EduBalbinot/ThreePhaseInverter/Resultados/T0000CH1.CSV

Model | DPO2024
Firmware Version | 1.25
Point Format | Y
Horizontal Units | S
Horizontal Scale | 1e-05
Sample Interval | 1e-09
Filter Frequency | 2e+08
Record Length | 100000
Gating | 0.0% to 100.0%
Probe Attenuation | 10
Vertical Units | V
Vertical Offset | 0
Vertical Scale | 50
Label
TIME | CH1
-4.87200e-05 | -3
-4.87190e-05 | -5
-4.87180e-05 | -3
-4.87170e-05 | -3
-4.87160e-05 | -5
-4.87150e-05 | -5
-4.87140e-05 | -5
-4.87130e-05 | -5
-4.87120e-05 | -5
-4.87110e-05 | -5
-4.87100e-05 | -5
-4.87090e-05 | -5
-4.87080e-05 | -3
-4.87070e-05 | -3
-4.87060e-05 | -5
-4.87050e-05 | -3
-4.87040e-05 | -5
-4.87030e-05 | -3
-4.87020e-05 | -5
-4.87010e-05 | -5
-4.87000e-05 | -5
-4.86990e-05 | -3
-4.86980e-05 | -3
-4.86970e-05 | -5
-4.86960e-05 | -5
-4.86950e-05 | -5
-4.86940e-05 | -5
-4.86930e-05 | -5
-4.86920e-05 | -5
-4.86910e-05 | -5
-4.86900e-05 | -5
-4.86890e-05 | -3
-4.86880e-05 | -5
-4.86870e-05 | -5
-4.86860e-05 | -3
-4.86850e-05 | -5
-4.86840e-05 | -5
-4.86830e-05 | -5
-4.86820e-05 | -5
-4.86810e-05 | -5
-4.86800e-05 | -5
-4.86790e-05 | -5
-4.86780e-05 | -5
-4.86770e-05 | -5
-4.86760e-05 | -5
-4.86750e-05 | -3
-4.86740e-05 | -5
-4.86730e-05 | -3
-4.86720e-05 | -5
-4.86710e-05 | -5
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
