EduBalbinot/ThreePhaseInverter/Resultados/Filtro/TEK00000.BMP

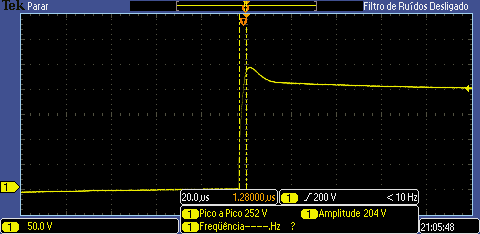
Resultados/Filtro/TEK00000.BMP
