EduBalbinot/ThreePhaseInverter/Resultados/TEK00000.PNG

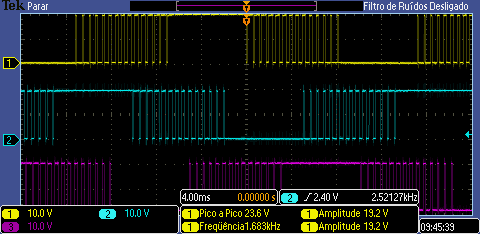
Resultados/TEK00000.PNG
