EduBalbinot/ThreePhaseInverter/Resultados/TEK00001.PNG

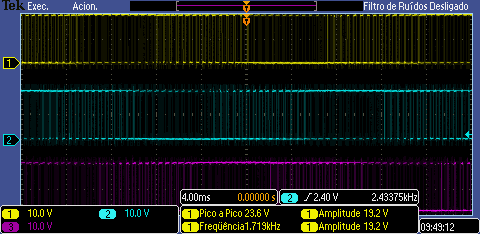
Resultados/TEK00001.PNG
