EduBalbinot/ThreePhaseInverter/Resultados/TEK00002.PNG

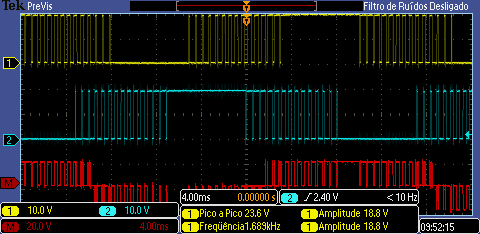
Resultados/TEK00002.PNG
