EduBalbinot/ThreePhaseInverter/Resultados/TEK00003.PNG

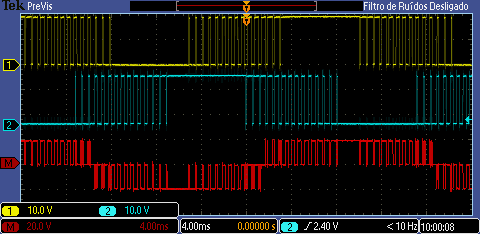
Resultados/TEK00003.PNG
