EduBalbinot/ThreePhaseInverter/Resultados/TEK00004.PNG

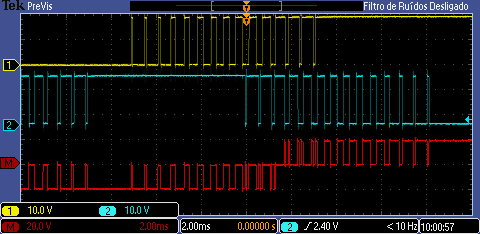
Resultados/TEK00004.PNG
