EduBalbinot/ThreePhaseInverter/Resultados/TEK00005.PNG

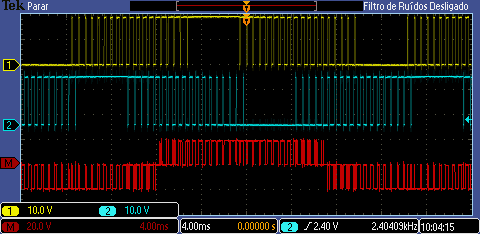
Resultados/TEK00005.PNG
