EduBalbinot/ThreePhaseInverter/Resultados/TEK00006.PNG

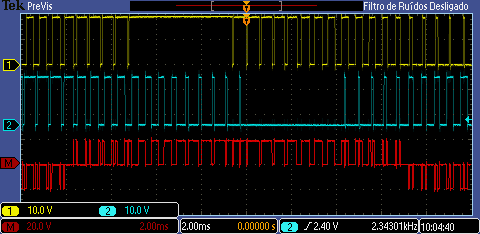
Resultados/TEK00006.PNG
