EduBalbinot/ThreePhaseInverter/Resultados/TEK00007.PNG

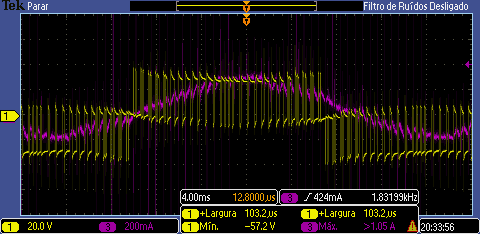
Resultados/TEK00007.PNG
