EduBalbinot/ThreePhaseInverter/Circuito/Reguladores.pdf

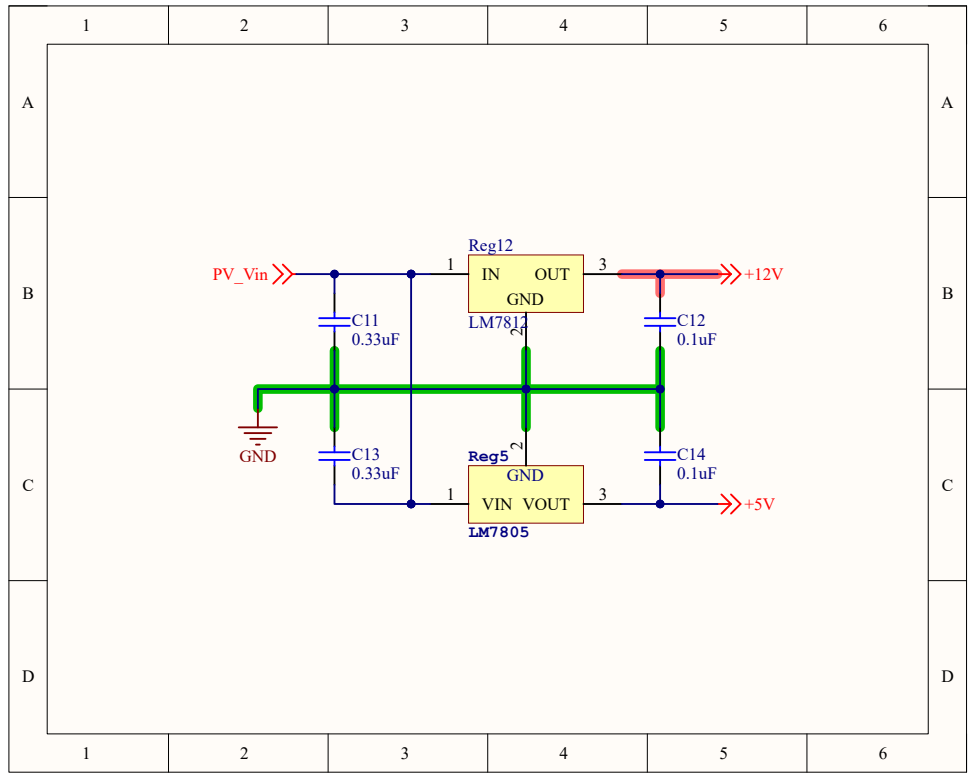
[picture p31: page 1]
OUT; GND; Reg12; VOUT; 3 VIN 1; Reg5; PV_Vin
