EduBalbinot/ThreePhaseInverter/Circuito/Arduino.pdf

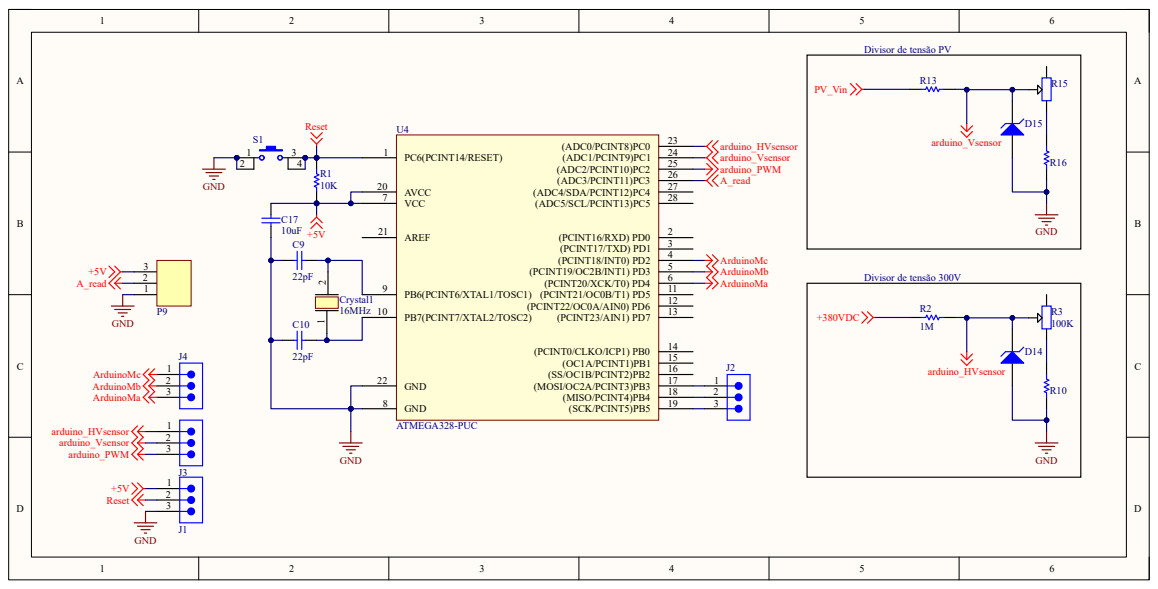
[picture p32: page 1]

Divisor de tensão PV
