EduBalbinot/ThreePhaseInverter/Circuito/Boost-flyback.pdf

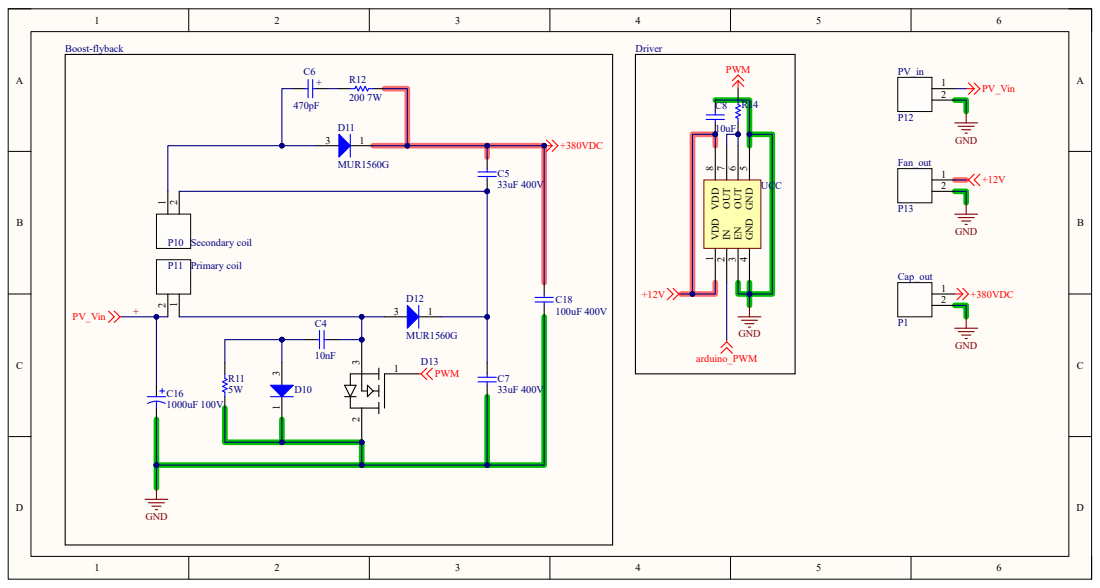
[picture p33: page 1]
