EduBalbinot/ThreePhaseInverter/Circuito/Inverter.pdf

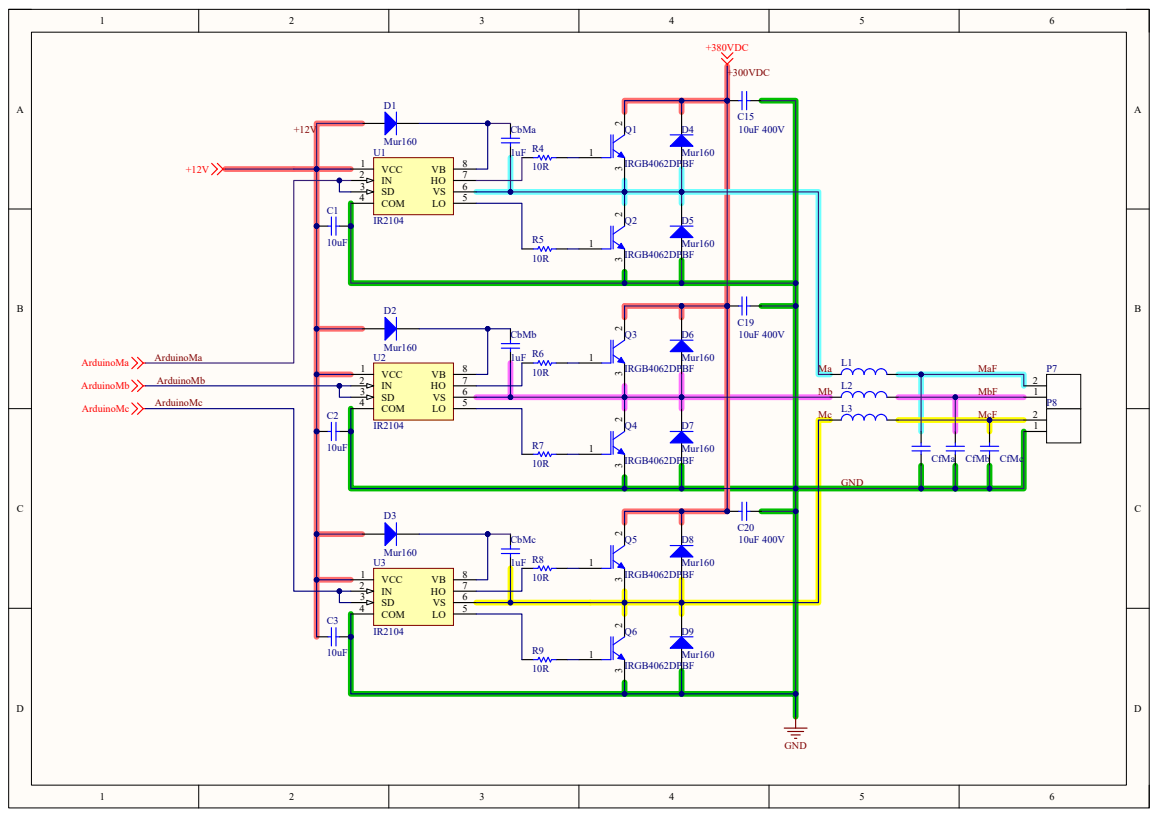
[picture p34: page 1]
