EduBalbinot/ThreePhaseInverter/Circuito/PCB.pdf

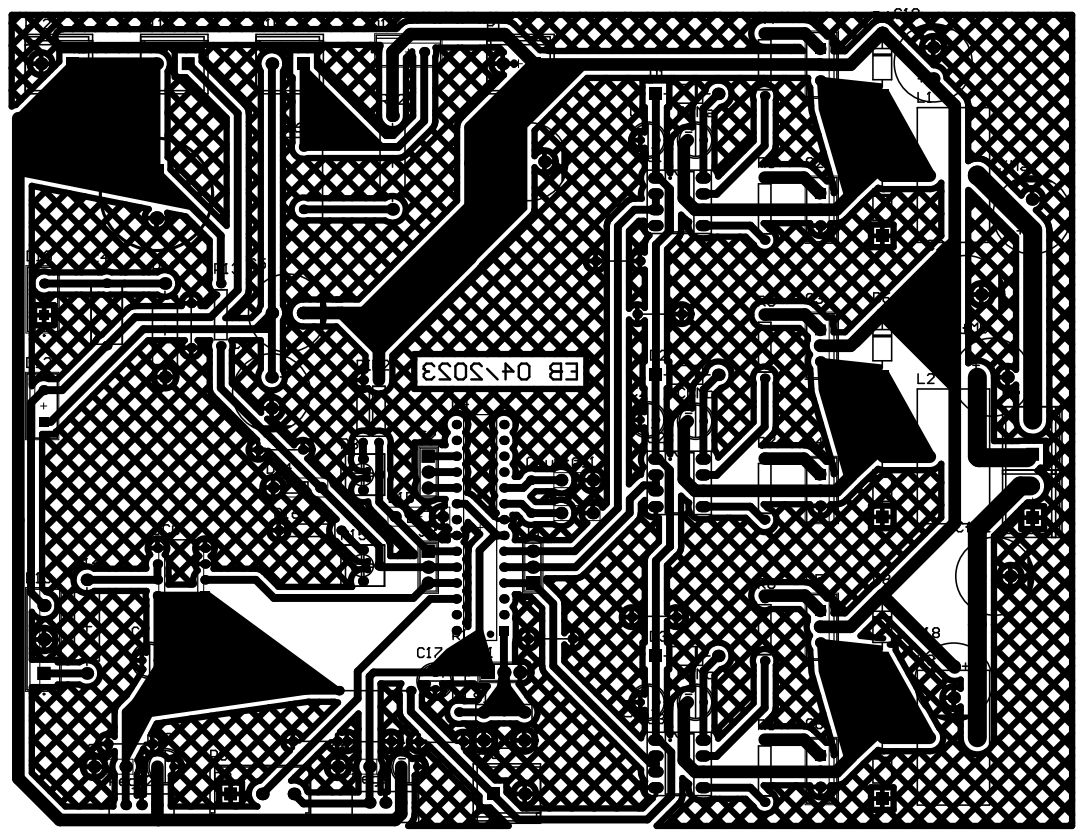
[picture p35: page 1]
