EduBalbinot/ThreePhaseInverter/Arduino/Converter and Inverter/TCC/data.hpp

/*
 * data.hpp
 *
 * Created: 04/05/2023 21:27:33
 *  Author: Eduardo Balbinot
 */ 

#ifndef DATA_HPP
#define DATA_HPP

struct moment{
	int counter;
	int port;
};
int lim = 305;
struct moment a[306] = {
	{216,28},
	{734,24},
	{656,8},
	{288,0},
	{604,8},
	{823,24},
	{145,28},
	{881,24},
	{494,8},
	{409,0},
	{446,8},
	{953,24},
	{79,28},
	{1014,24},
	{325,8},
	{549,0},
	{280,8},
	{1069,24},
	{36,28},
	{1133,24},
	{153,8},
	{705,0},
	{108,8},
	{1169,24},
	{17,28},
	{1212,24},
	{22,16},
	{789,0},
	{66,16},
	{1185,24},
	{23,28},
	{1121,24},
	{194,16},
	{625,0},
	{239,16},
	{1075,24},
	{54,28},
	{1013,24},
	{363,16},
	{477,0},
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
#endif
